officialgaia/candy-dispenser/電子回路/回路図.pdf

## お菓子ディスペンサー 回路図

同じ名前の緑のラベルどうしがつながっています。GNDはすべて共通です。

ESP32-C3 SuperMini

USBで給電

SCK | GPIO4
MISO | GPIO5
MOSI | GPIO6
SS | GPIO7
RST | GPIO10
IR | GPIO2
BUZ | GPIO3
DROP | GPIO9
GPIO0 | IN1
GPIO1 | IN2
GPIO20 | IN3
GPIO21 | IN4
5V | 5V
3V3 | 3V3
GND

RC522

ICカード

3V3 3.3V
GND
SDA | SS
SCK | SCK
MOSI | MOSI
MISO | MISO
RST | RST
3V3
+ 10µF

RC522の電源

HX1838B

赤外線受信

3V3 VCC
GND

DO IR

パッシブブザー

− | S

150Ω
BUZ

障害物検知

出口の筒の横

3V3 ＋
GND
ジャンパーのまま | EN
OUT | DROP

ULN2003

モータードライバ

IN1 | IN1
IN2 | IN2
IN3 | IN3
IN4 | IN4
＋ | 5V
−

白コネクタ

M 28BYJ-48

5V
+ 470µF

モーターの電源

5V

220Ω

RGB LEDモジュール
光らせる色の数だけ
抵抗を通して5Vへ

5V

220Ω

3色LEDモジュール
光らせる色の数だけ
抵抗を通して5Vへ

・RC522、赤外線受信、障害物センサーの電源は3.3V（5Vにつながない） ・GPIO9は起動時にLOWだと書き込みモードになるので、出口の筒が空の状態で電源を入れる ・コンデンサは＋側を電源へ。ULN2003の電源は5V（USBのVBUS） ・LEDはESP32のピンを使わず常時点灯（例：水色＝G＋B）
