officialgaia/candy-dispenser/配線図.png

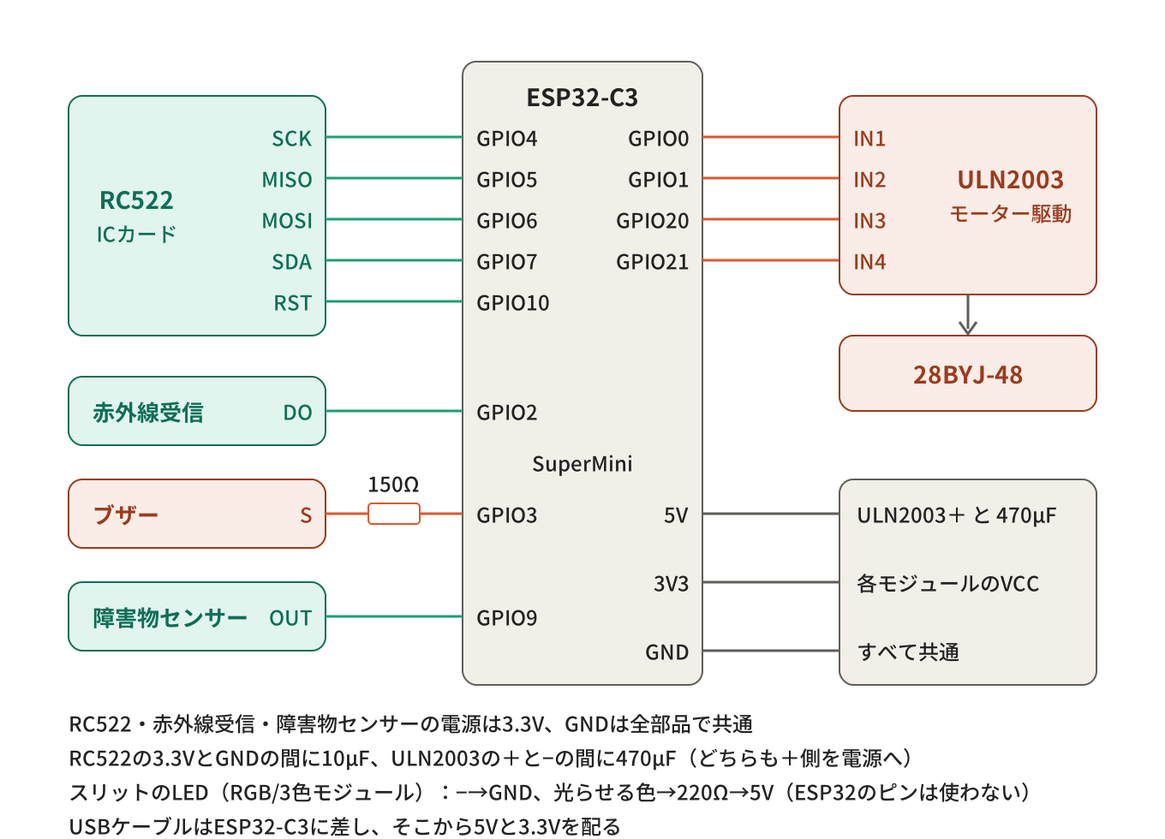
配線図.png
