officialgaia/candy-dispenser/部品表.md

# お菓子ディスペンサー 部品表

オンライン版（編集可）：https://claude.ai/artifact/6ckYaY9mjTyi7CCLxRRTnj

## 電子部品（買い足すのはモーターのセットだけ）

| 部品 | 数量 | 用途 | 接続先 | 在庫 |
| --- | --- | --- | --- | --- |
| 28BYJ-48 ＋ ULN2003（5V版） | 1セット | 円盤を回す | GPIO0, 1, 20, 21、電源5V | 要購入 |
| ESP32-C3 SuperMini | 1 | 全体の制御 | — | あり |
| RFIDリーダー RC522 | 1 | ICカードの読み取り | GPIO4〜7, 10、電源3.3V | あり |
| MIFARE S50 カード／タグ | 最大4 | 利用者のカード | — | あり |
| 赤外線リモコンセット（HX1838） | 1 | 杯数の入力（1杯≈5粒） | GPIO2、電源3.3V | あり |
| パッシブブザーモジュール | 1 | 音で知らせる | GPIO3（150Ω経由） | あり |
| 障害物検知モジュール | 1 | 1杯ごとに落ちたかの検知 | GPIO9、電源3.3V | あり |
| RGB LEDモジュール | 1 | 右のスリットの光 | 220Ω経由で5V | あり |
| 3色LEDモジュール | 1 | 左のスリットの光 | 220Ω経由で5V | あり |
| 抵抗 150Ω | 1 | ブザーの電流制限 | — | あり |
| 抵抗 220Ω | 4〜6 | LEDの電流制限 | — | あり |
| 電解コンデンサ 470µF | 1 | モーター電源の安定 | ULN2003の＋と− | あり |
| 電解コンデンサ 10µF | 1 | RC522電源の安定 | RC522の3.3VとGND | あり |
| ジャンパワイヤ | 約30本 | 配線 | — | あり |
| USBケーブル | 1 | 電源と書き込み | — | あり |

## 3Dプリント部品

| ファイル | 部品 | 大きさ |
| --- | --- | --- |
| disc.stl | 回転円盤（穴4個、1穴≈5粒） | Φ80 × 15.5 mm |
| base.stl | 円盤の底板（モーター取付） | Φ102 × 21 mm |
| adapter.stl | じょうごと投入口の変換口 | Φ91 × 15 mm |
| sensor_tube.stl | 障害物センサー用の筒 | 78 × 35 × 16 mm |

## MDF 3 mm（33枚）

「レーザー加工_MDF3mm」フォルダのSVGを参照。ファイル名の `_x2` は枚数。

## その他

| 材料 | 数量 | 用途 |
| --- | --- | --- |
| M3ネジ＋ナット | 7組 | モーター2、底板3、センサーの筒2 |
| 黒の塗料 | 適量 | 外装（塗ってから彫刻） |
| 木工用接着剤 | 適量 | 板の組み立て |
| 食品対応のコーティング剤か食品用シート | 適量 | 内箱・じょうご・引き出しの内側 |
| シリコンシートの切れ端 | 1 | 詰まり防止のフラップ（任意） |
