officialgaia/candy-dispenser/組み立て済みモデル/assembly.3mf

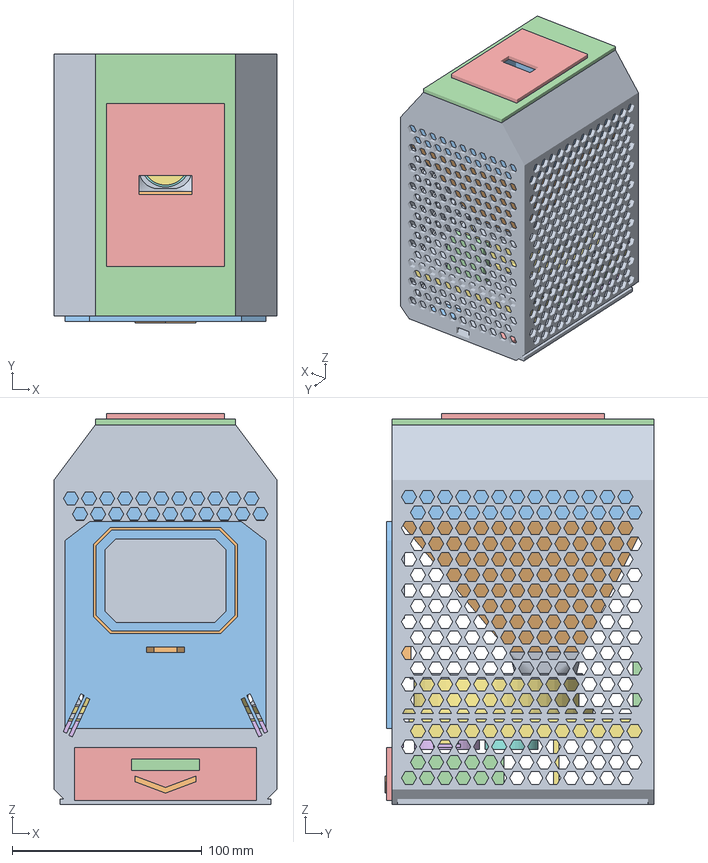
[picture p2: CAD file, 2026-11-09]
組み立て済みモデル/assembly.3mf
117.4 x 141.6 x 206.0 mm
geometry_0
geometry_1
geometry_2
geometry_3
geometry_4
geometry_5
geometry_6
geometry_7
geometry_8
geometry_9
geometry_10
geometry_11
geometry_12
geometry_13
geometry_14
geometry_15
geometry_16
geometry_17
geometry_18
geometry_19
geometry_20
geometry_21
geometry_22
