officialgaia/candy-dispenser/3Dプリント/base.stl

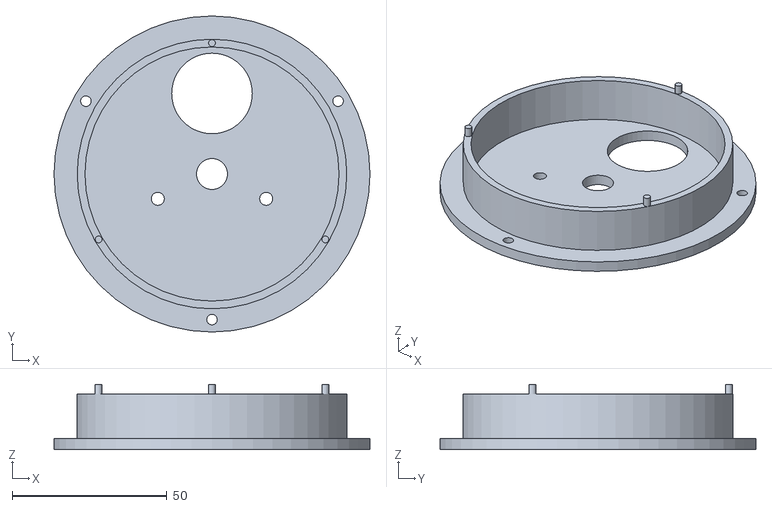
[picture p3: CAD file, 2026-11-09]
3Dプリント/base.stl
102.0 x 102.0 x 21.0
