officialgaia/candy-dispenser/3Dプリント/disc.stl

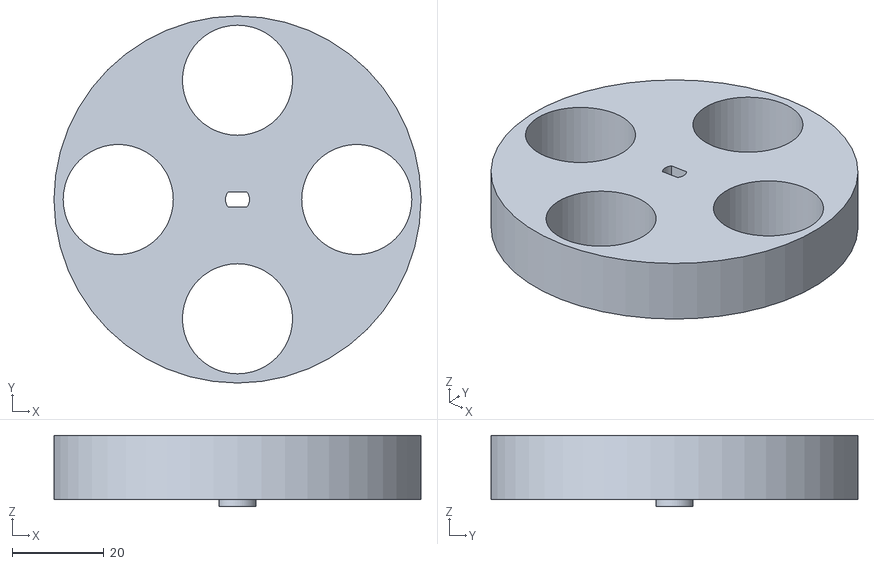
[picture p4: CAD file, 2026-11-09]
3Dプリント/disc.stl
80.0 x 80.0 x 15.5
