officialgaia/candy-dispenser/3Dプリント/adapter.stl

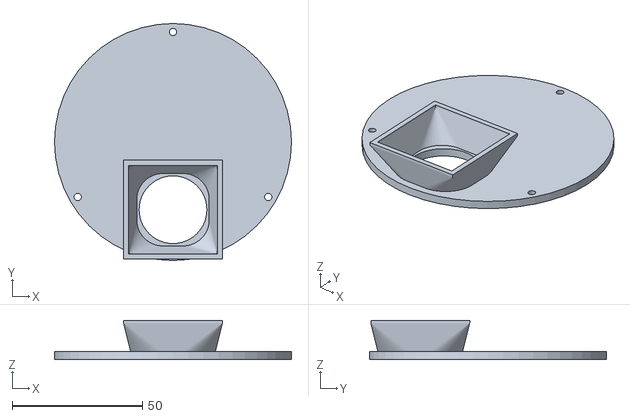
[picture p5: CAD file, 2026-11-09]
3Dプリント/adapter.stl
91.0 x 91.0 x 15.0
