officialgaia/candy-dispenser/3Dプリント/sensor_tube.stl

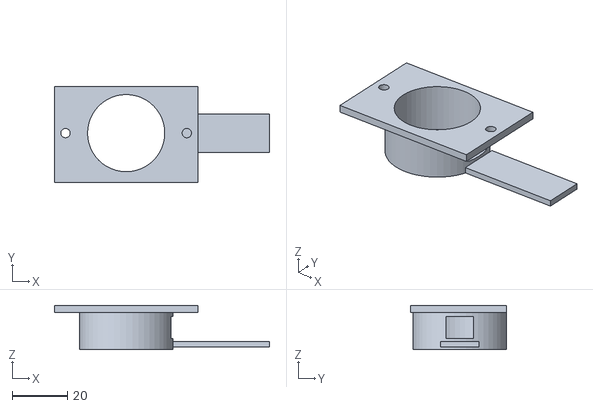
[picture p6: CAD file, 2026-11-09]
3Dプリント/sensor_tube.stl
78.0 x 35.0 x 16.0
