officialgaia/candy-dispenser/(commit log)

2026-11-07 お菓子ディスペンサーの設計一式を追加
    ESP32-C3のコード、3Dプリント部品（STL）、MDFレーザー加工データ（300×225mm 4枚）、
    回路図・配線表、組み立て済みモデル、部品表、設計スクリプトを収録。
    Claude-Session: https://claude.ai/code/session_01MKA5kpyikdmuDnMEfWfVfc
    [adapter.stl, assembly.3mf, base.stl, disc.stl, sensor_tube.stl, 配線表.csv]
2026-11-09 寸法チェックで見つかった干渉と余裕不足を修正
    - 底板（base.stl）をΦ80→Φ86にし、中棚に留めるネジ穴の外側の肉厚を0.6mm→約2mmに
    - センサー用の筒のつばを短くし、モーターに当たらないよう3mmのすき間を確保
    - 天板が正面・背面の板と重なっていたので、板の上に載せる配置に変更（高さ203→206mm）
    - 中棚のネジ穴位置をSVGに反映し、MDFの割り付けを更新
    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
    [assembly.3mf, base.stl, sensor_tube.stl]
2026-11-09 円盤の穴を「1穴≈M&M5粒」に変更し、関係する部品とコードを合わせて修正
    - 円盤：穴Φ15.5×6個・厚さ8 → 穴Φ24×4個・厚さ14（1穴約6.3cm³）、Φ64→Φ80
    - 底板Φ102・壁を高く、出口と投入口をΦ26に。変換口Φ91、上の口34×34
    - 回転部を前に14mmずらし、じょうごの傾斜を45°以上に（上端z150、内箱の高さ18mm）
    - 中棚の出口Φ28・ネジ穴、センサーの筒（内径Φ28）を新しい出口位置に合わせた
    - 赤外線の窓を変換口に当たらない高さに移動
    - コード：粒数→杯数（1杯≈5粒）、穴4個、1杯ごとに落下を確認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
    [adapter.stl, assembly.3mf, base.stl, disc.stl, sensor_tube.stl]
2026-11-09 内箱を外壁の内側いっぱいに広げて接着できるようにした（じょうご・SVG・3Dモデル更新、固定方法を追記）
    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
    [assembly.3mf]
2026-11-09 円盤を底板の床に直接のせ、中棚の下に受け木と縦リブを追加（MDF 33枚・4枚の板に割り付け）
    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
    [assembly.3mf, base.stl, disc.stl]
2026-11-09 Wi-Fiなしでも1日の回数制限が働くようにした（USE_WIFI設定を追加）
    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
2026-11-09 Arduino IDEでsetModeの自動宣言がMode型より先に入るエラーを修正
    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
    [candy_dispenser.ino]
2026-11-09 3Dモデルを部品ごとに作り直し（色分け・分解スライダー・部品一覧と説明）
    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
2026-11-09 赤外線リモコンを外し、操作をICカードだけにした（管理カードで登録・削除、かざした回数で杯数）
    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
    [assembly.3mf, 配線表.csv]
2026-11-09 赤外線リモコンを元に戻した（「赤外線リモコンを外し…」を取り消し）
    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
    [assembly.3mf, 配線表.csv]
